SolidEkans/Flux-Capacitors/RESEARCH/Stock 350 SBC Timing Table.PNG

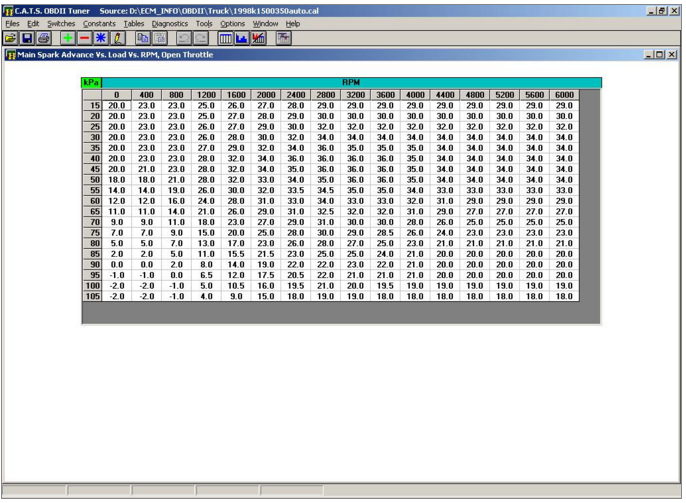
RESEARCH/Stock 350 SBC Timing Table.PNG
