SolidEkans/Flux-Capacitors/README.md

# Flux-Capacitors
Ryan Kachline
Calvin Nelson 
senior design timing box
