SolidEkans/Flux-Capacitors/SRC/Read Me.txt

The coding environment that you need is the Arduino coding enviroment.
A download for it is found at: https://www.arduino.cc/en/Main/Software
