SolidEkans/Flux-Capacitors/DESIGN_DOCUMENTATION/Flux Capacitors Schedule.xls

EE 403W Flux Capacitors, Ignition Timing Delay Box (ITDB) Spring 2016 Schedule
Week | Monday Lab 2:30PM- 4:25PM 301 EEW | Wednesday Lab 2:30PM- 4:25PM 301 EEW | Notes
2016-02-01 | Aquire Microcontroller, Probe Ignition on Car
2016-02-08 | Preliminary Design
2016-02-15 | Have Working Push button Delay
2016-02-22 | Design Power filter, Milestone Report
2016-02-29 | PCB Design
2016-03-07 | Spring Break | Spring Break | Spring Break
2016-03-14 | Assembly
2016-03-21 | Packaging Design
2016-03-28 | Stretch Goals
2016-04-04 | Stretch Goals, Milestone Report
2016-04-11 | Stretch Goals
2016-04-18 | Stretch Goals
2016-04-25 | Stretch Goals, Final Review
