SolidEkans/Flux-Capacitors/DESIGN_DOCUMENTATION/FluxCapacitors.PCBDesign/SCHEMATICS/FluxCapacitors.Schematic.pdf

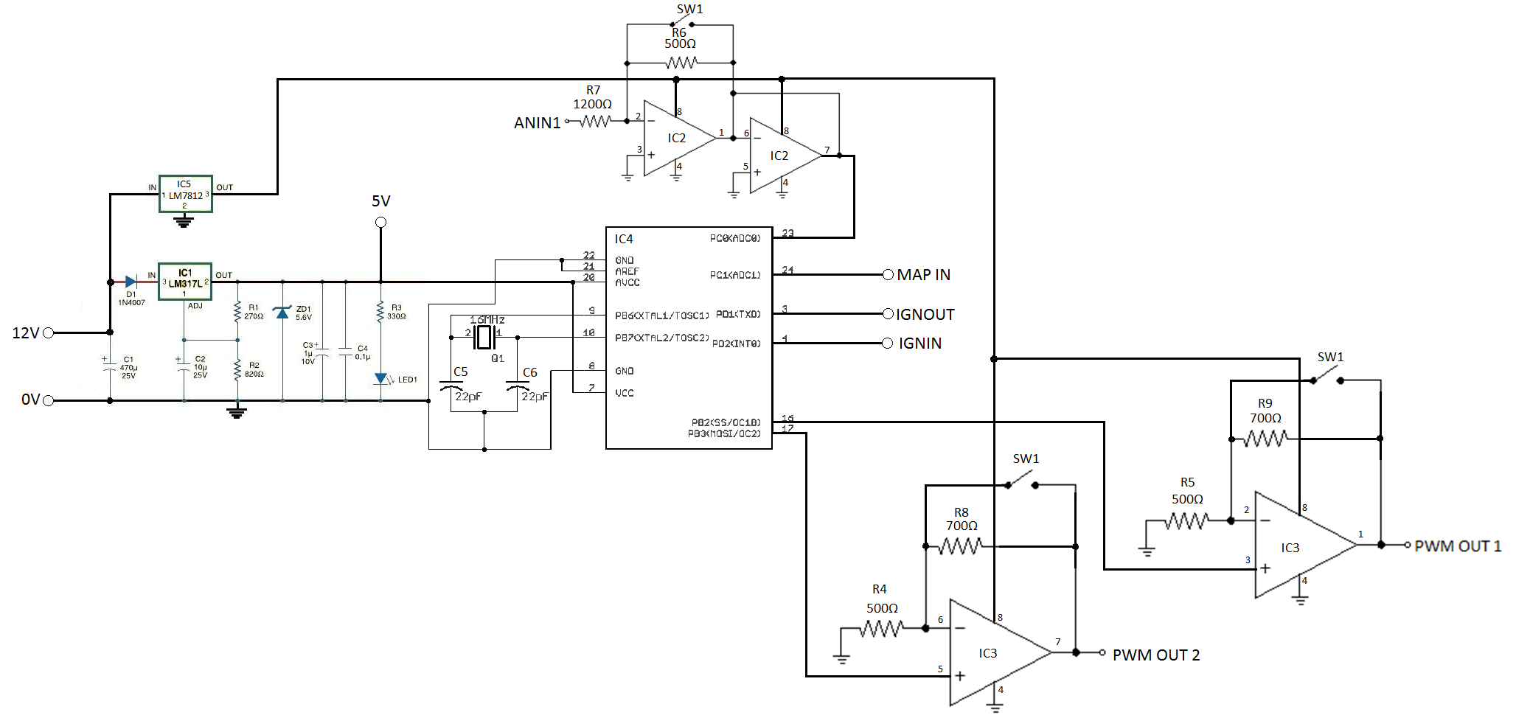
[picture p20: figure]
