SolidEkans/Flux-Capacitors/Grades/Design Review 1 Grades.xlsx

Flux Capacitors | External Reviewers |  |  |  | Students |  |  |  |  |  |  |  |  | Avg External Reviewer Score | AVG Student Score
Presentation Item | C | M | L | E |  |  |  |  |  |  |  |  |  |  |  | Weighted | Final Score
Did you understand the team's technical approach and how their proposed solution is supposed to work? | 9 | 10 | 9 | 10 | 9 | 7 | 9 | 10 | 7 | 7 | 7 | 7 | 10 | 9.5 | 7.875 | 8.6875 | 86.875
Rate the quality of the team's specifications. Were they stated clearly and did they describe quantifiable performance measures? | 9 | 8 | 8 | 10 | 9 | 9 | 9 | 10 | 8 | 9 | 9 | 7 | 9 | 8.75 | 8.75 | 8.75
Did team show any experimental data or technical progress? | 9 | 8 | 8 | 10 | 9 | 9 | 10 | 10 | 9 | 9 | 9 | 7 | 7 | 8.75 | 9 | 8.875
Did team know what their problem areas were? | 8 | 8 | 7 | 10 | 8 | 10 | 10 | 8 | 9 | 9 | 8 | 8 | 7 | 8.25 | 8.75 | 8.5
Rate overall progress on the project to-date | 8 | 8 | 8 | 10 | 8 | 10 | 10 | 10 | 9 | 10 | 8 | 9 | 6 | 8.5 | 9.25 | 8.875
Rate team's explanations of project challenges and risks | 7 | 9 | 8 | 10 | 7 | 9 | 9 | 9 | 9 | 8 | 8 | 8 | 10 | 8.5 | 8.375 | 8.4375
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
