SolidEkans/Flux-Capacitors/RESEARCH/Sine Phase Shifter Circuit.png

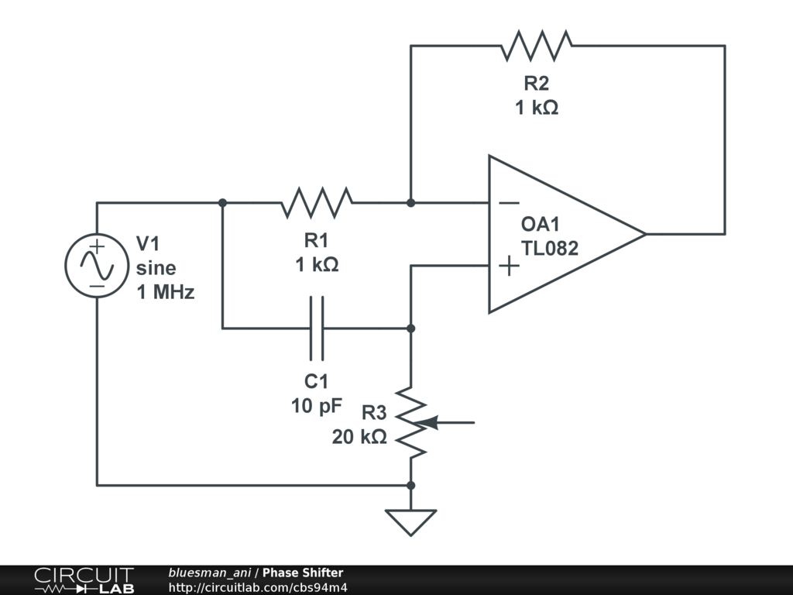
RESEARCH/Sine Phase Shifter Circuit.png
