SolidEkans/Flux-Capacitors/FluxCapacitors.PCBDesign/BOM/BOM.xlsx

Description | Quantity | Part Name On Schematic | Notes | Manufacturer | Manufacturer part Number | Source Part Number | Link | Unit Price | Ammount
atmega socket | 1 | socket |  | 3M | 4828-3004-CP | 3M5480-ND | http://www.digikey.com/product-detail/en/4828-3004-CP/3M5480-ND/1133633 | $0.73 | $0.73
16MHz crystal | 1 | Q1 |  | CTS-Frequency Controls | ATS16B | CTX1085-ND | http://www.digikey.com/product-detail/en/cts-frequency-controls/ATS16B/CTX1085-ND/2640031 | $0.36 | $0.36
22 pF cap | 2 | C5,C6 | "0805" polarized | Yageo | CC0805JRNPO9BN220 | 311-1103-1-ND | http://www.digikey.com/product-detail/en/yageo/CC0805JRNPO9BN220/311-1103-1-ND/303013 | $0.10 | $0.20
470 uF | 1 | C1 | polarized throughhole | Vishay BC Components | MAL202136471E3 | 4037PHCT-ND | http://www.digikey.com/product-detail/en/vishay-bc-components | $2.13 | $2.13
10 uF | 1 | C2 | "0805" | Murata Electronics North America | GCJ21BR71A106KE01L | 490-12646-1-ND | http://www.digikey.com/product-detail/en/GCJ21BR71A106KE01L/490-12646-1-ND/5797615 | $0.56 | $0.56
1 uF | 1 | C3 | "0805" | TDK Corporation | C2012X8R1C105K125AE | 445-173676-1-ND | http://www.digikey.com/product-detail/en/C2012X8R1C105K125AE/445-173676-1-ND/5809747 | $0.56 | $0.56
.1 uF | 1 | C4 | "0805" | Murata Electronics North America | GRM219R71E104KA01D | 490-12754-1-ND | http://www.digikey.com/product-detail/en/GRM219R71E104KA01D/490-12754-1-ND/5797723 | $0.12 | $0.12
LED | 1 | LED1 |  | Cree Inc. | C4SMF-GJS-CV0Y0792 | C4SMF-GJS-CV0Y0792CT-ND | http://www.digikey.com/product-detail/en/cree-inc/C4SMF-GJS-CV0Y0792/C4SMF-GJS-CV0Y0792CT-ND/1987473 | $0.29 | $0.29
5.6 v Zener | 1 | ZD1 |  | NXP Semiconductors | BZX79-C5V6 | 568-3846-1-ND | http://www.digikey.com/product-detail/en/BZX79-C5V6,133/568-3846-1-ND/1163127 | $0.13 | $0.13
1N4007 diode | 1 | D1 |  | Micro Commercial Co | 1N4007-TP | 1N4007-TPMSCT-ND | http://www.digikey.com/product-detail/en/micro-commercial-co/1N4007-TP/1N4007-TPMSCT-ND/773694 | $0.11 | $0.11
LM317L voltage regulator | 1 | IC1 |  | ON Semiconductor | LM317TG | LM317TGOS-ND | http://www.digikey.com/product-detail/en/LM317TG/LM317TGOS-ND/918508 | $0.53 | $0.53
wire sockets | 1 | wire harness | 10 sockets | TE Connectivity AMP Connectors | 1-1437664-4 | 1-1437664-4-ND | http://www.digikey.com/product-detail/en/te-connectivity-amp-connectors/1-1437664-4/1-1437664-4-ND/2258981 | $6.70 | $6.70
opamp | 2 | IC2 IC3 | ask eli | Fairchild Semiconductor | LF353N | LF353NFS-ND | http://www.digikey.com/product-detail/en/fairchild-semiconductor/LF353N/LF353NFS-ND/458668 | $0.51 | $1.02
270 ohm Resistor | 1 | R1 | "0603" | Yageo | RC0603JR-07270RL | 311-270GRCT-ND | http://www.digikey.com/product-detail/en/RC0603JR-07270RL/311-270GRCT-ND/729696 | $0.10 | $0.10
820 ohm resistor | 1 | R2 | "0603" | Yageo | RC0603JR-07820RL | 311-820GRCT-ND | http://www.digikey.com/product-detail/en/RC0603JR-07820RL/311-820GRCT-ND/729779 | $0.10 | $0.10
330 ohm resistor | 1 | R3 | "0603" | Yageo | RC0603JR-07330RL | 311-330GRCT-ND | http://www.digikey.com/product-detail/en/RC0603JR-07330RL/311-330GRCT-ND/729716 | $0.10 | $0.10
500 ohm resistor | 3 | R4 R5 R6 | "0603" | Yageo | RC0603FR-07499RL | 311-499HRCT-ND | http://www.digikey.com/product-detail/en/yageo/RC0603FR-07499RL/311-499HRCT-ND/730213 | $0.10 | $0.30
1200 ohm resistor | 1 | R7 | "0603" | Yageo | RC0603JR-071K2L | 311-1.2KGRCT-ND | http://www.digikey.com/product-detail/en/yageo/RC0603JR-071K2L/311-1.2KGRCT-ND/729630 | $0.10 | $0.10
700 ohm resistor | 2 | R8 R9 | "0603" | Stackpole Electronics Inc. | RMCF0603FT698R | RMCF0603FT698RCT-ND | http://www.digikey.com/product-detail/en/stackpole-electronics-inc/RMCF0603FT698R/RMCF0603FT698RCT-ND/1942992 | $0.10 | $0.20
aux voltage reg | 1 | IC5 |  | Fairchild Semiconductor | LM7812CT | LM7812CTFS-ND | http://www.digikey.com/product-detail/en/fairchild-semiconductor/LM7812CT/LM7812CTFS-ND/1923051 | $0.64 | $0.64
dip switch | 1 | SW1 | 3 switches | Omron Electronics Inc | A6S-3101-H | SW1386-ND | http://www.digikey.com/product-detail/en/omron-electronics-inc-emc-div/A6S-3101-H/SW1386-ND | $1.86 | $1.86
MCU | 1 | IC4 |  | Atmel | ATMEGA328-PU | ATMEGA328-PU-ND | http://www.digikey.com/product-detail/en/atmel/ATMEGA328-PU/ATMEGA328-PU-ND/2271026 | $3.38 | $3.38
 |  |  |  |  |  |  |  |  | $20.22
