SolidEkans/Flux-Capacitors/RESEARCH/parts list.xlsx

atmega socket | 1 | mcu |  | http://www.digikey.com/product-detail/en/4828-3004-CP/3M5480-ND/1133633
16MHz crystal | 1 | clk |  | stockroom? http://www.digikey.com/product-detail/en/ATS16B/CTX1085-ND/2640031
22 pF cap | 2 | C5,C6 | "0805" polarized | http://www.digikey.com/product-detail/en/CC0805JRNPO9BN220/311-1103-1-ND/303013
470 uF | 1 | C1 | polarized throughhole | stockroom
10 uF | 1 | C2 | 0805 polarized | http://www.digikey.com/product-detail/en/GCJ21BR71A106KE01L/490-12646-1-ND/5797615
1 uF | 1 | C3 | 0805 polarized | http://www.digikey.com/product-detail/en/C2012X8R1C105K125AE/445-173676-1-ND/5809747
.1 uF | 1 | C4 | 0805 unpolar | http://www.digikey.com/product-detail/en/GRM219R71E104KA01D/490-12754-1-ND/5797723
LED | 1 | LED |  | stockroom
5.6 v Zener | 1 | Zener |  | stockroom?? http://www.digikey.com/product-detail/en/BZX79-C5V6,133/568-3846-1-ND/1163127
1N4007 diode | 1 | Diode |  | stockroom
LM317L voltage regulator | 1 | Vreg |  | http://www.digikey.com/product-detail/en/LM317TG/LM317TGOS-ND/918508 (stockroom??)
wire sockets | 10 sockets |  |  | http://www.digikey.com/product-detail/en/te-connectivity-amp-connectors/1-1437664-4/1-1437664-4-ND/2258981
opamp 4 op amps(2 dips) | 2 |  | ask eli | http://www.digikey.com/product-detail/en/fairchild-semiconductor/LF353N/LF353NFS-ND/458668
270 ohm Resistor | 1 | R1 | "0603" | http://www.digikey.com/product-detail/en/RC0603JR-07270RL/311-270GRCT-ND/729696
820 ohm resistor | 1 | R2 | "0603" | http://www.digikey.com/product-detail/en/RC0603JR-07820RL/311-820GRCT-ND/729779
330 ohm resistor | 1 | R3 | "0603" | http://www.digikey.com/product-detail/en/RC0603JR-07330RL/311-330GRCT-ND/729716
500 ohm resistor | 3 | R2 MAP / (R1DIO11/12) | "0603" | http://www.digikey.com/product-detail/en/yageo/RC0603FR-07499RL/311-499HRCT-ND/730213
1200 ohm resistor | 1 | R1MAP | "0603" | http://www.digikey.com/product-detail/en/yageo/RC0603JR-071K2L/311-1.2KGRCT-ND/729630
700 ohm resistor | 2 | R2DIO11/12 | "0603" | http://www.digikey.com/product-detail/en/stackpole-electronics-inc/RMCF0603FT698R/RMCF0603FT698RCT-ND/1942992
aux voltage reg |  |  |  | http://www.digikey.com/product-detail/en/fairchild-semiconductor/LM7812CT/LM7812CTFS-ND/1923051
