SolidEkans/Flux-Capacitors/WORKING FILES/Accuracy Testing.xlsx

Delay (degrees) | Measured Delay (ms) | Theoretical Delay (ms) | Measured Dwell (ms) | Straddling Negative edge?
f=12Hz, T=0.083333, 180RPM
3 | 2.86 | 2.777776667 | 3.1 | y | 0.9712505828 | -0.08222333333
4 | 3.84 | 3.703702222 | 3.64 | n | 0.964505787 | -0.1362977778
5 | 4.76 | 4.629627778 | 3.64 | n | 0.9726108777 | -0.1303722222
6 | 5.68 | 5.555553333 | 3.64 | n | 0.9780903756 | -0.1244466667
7 | 6.64 | 6.481478889 | 3.64 | n | 0.9761263387 | -0.1585211111
8 | 7.54 | 7.407404444 | 3.64 | n | 0.9824143826 | -0.1325955556
9 | 8.48 | 8.33333 | 3.64 | n | 0.9827040094 | -0.14667
10 | 9.44 | 9.259255556 | 3.64 | n | 0.9808533427 | -0.1807444444
15 | 14.06 | 13.88888333 | 3.64 | n | 0.9878295401 | -0.1711166667
20 | 18.7 | 18.51851111 | 3.64 | n | 0.9902947118 | -0.1814888889
25 | 23.4 | 23.14813889 | 3.64 | n | 0.9892367047 | -0.2518611111
30 | 28.05 | 27.77776667 | 3.64 | n | 0.9902947118 | -0.2722333333
35 | 32.7 | 32.40739444 | 3.64 | n | 0.9910518179 | -0.2926055556
40 | 37.4 | 37.03702222 | 3.64 | n | 0.9902947118 | -0.3629777778
45 | 42 | 41.66665 | 3.64 | n | 0.9920630952 | -0.33335
50 | 46.7 | 46.29627778 | 3.64 | n | 0.9913549845 | -0.4037222222
f=50Hz, T=0.02, 750RPM
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
