SolidEkans/Flux-Capacitors/TESTING/Mag pickup 2.png

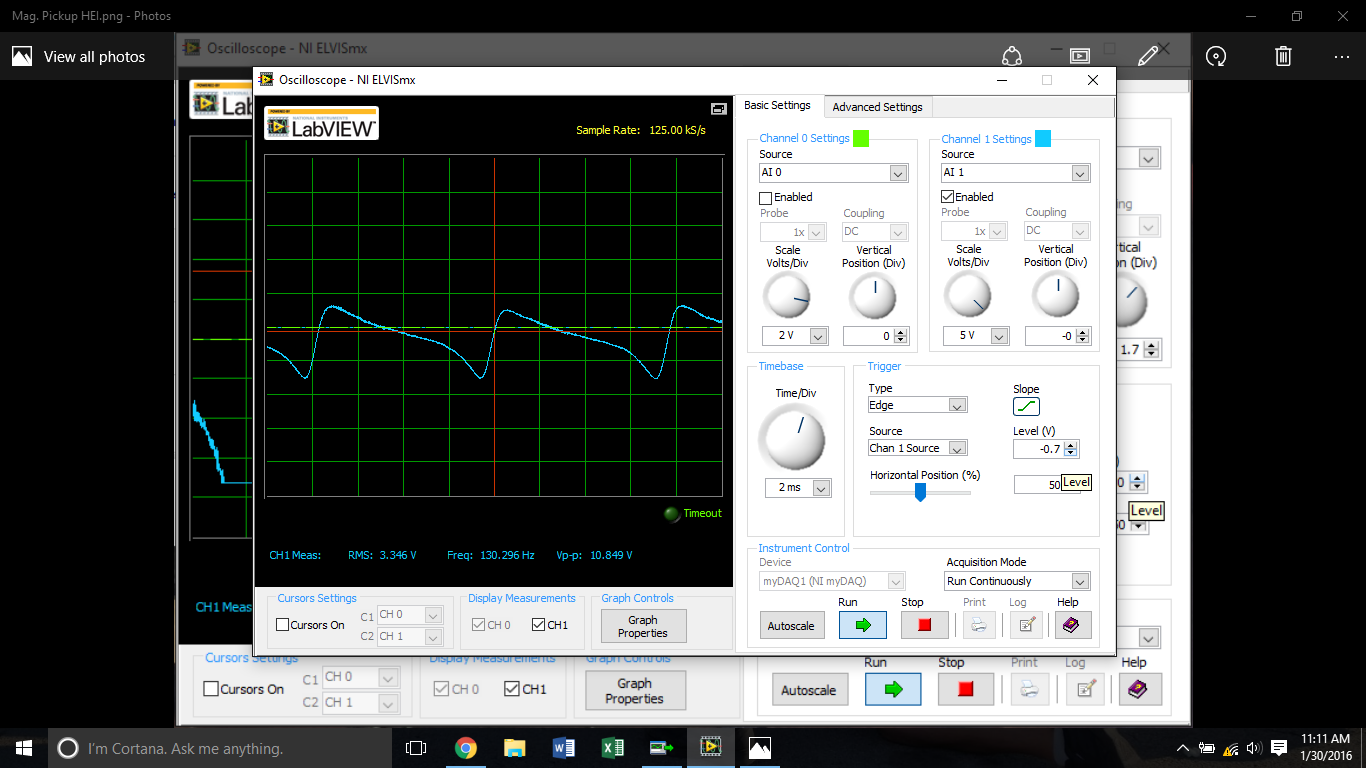
TESTING/Mag pickup 2.png
