SolidEkans/Flux-Capacitors/TESTING/mag pickup 3.png

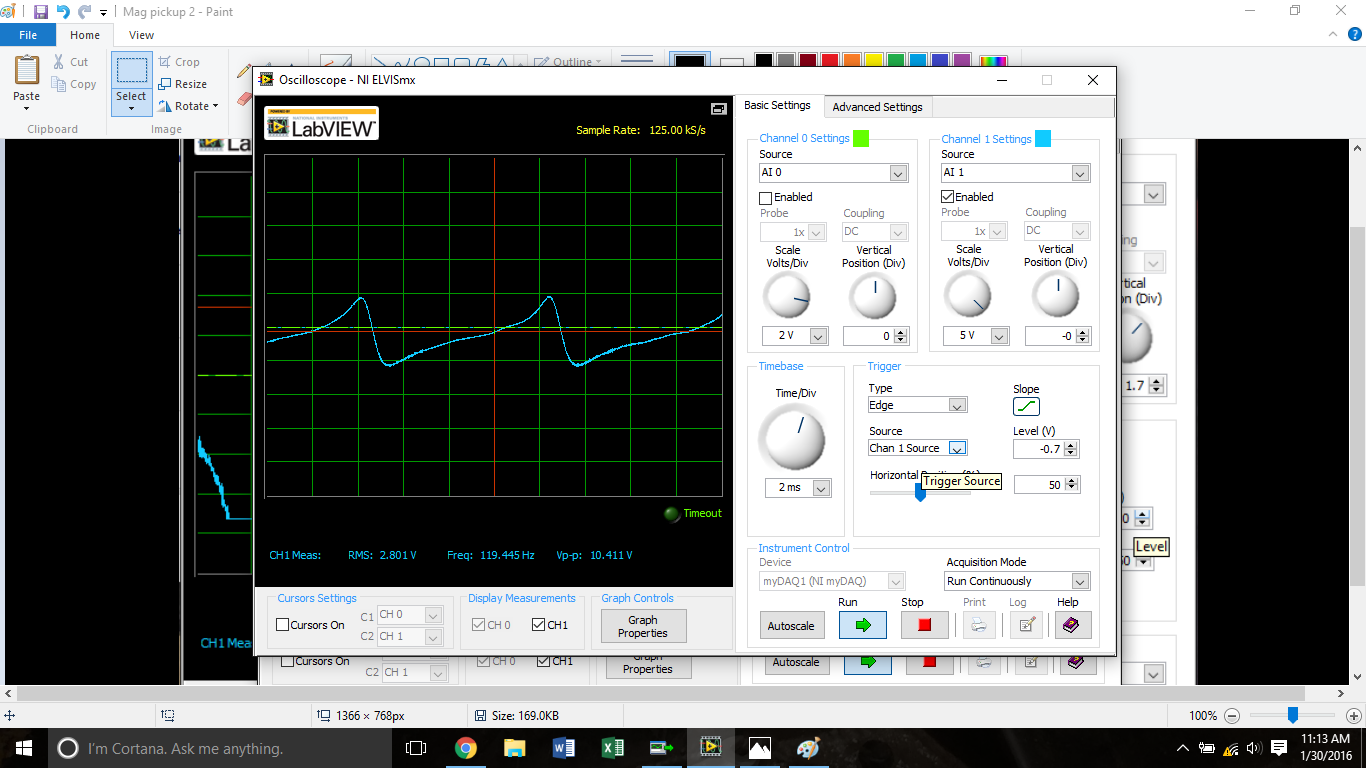
TESTING/mag pickup 3.png
