SolidEkans/Flux-Capacitors/TESTING/Mag. Pickup HEI.png

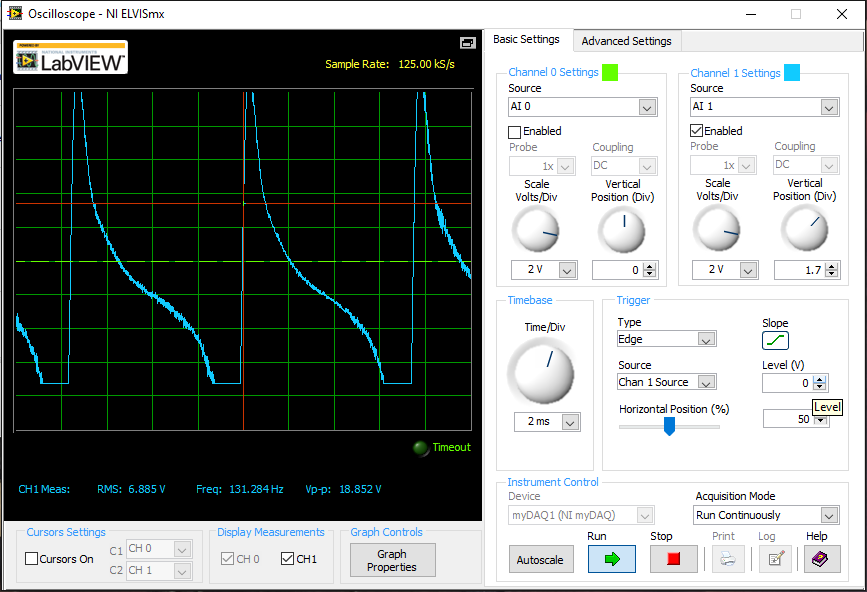
TESTING/Mag. Pickup HEI.png
