SolidEkans/Flux-Capacitors/TESTING/R signal.png

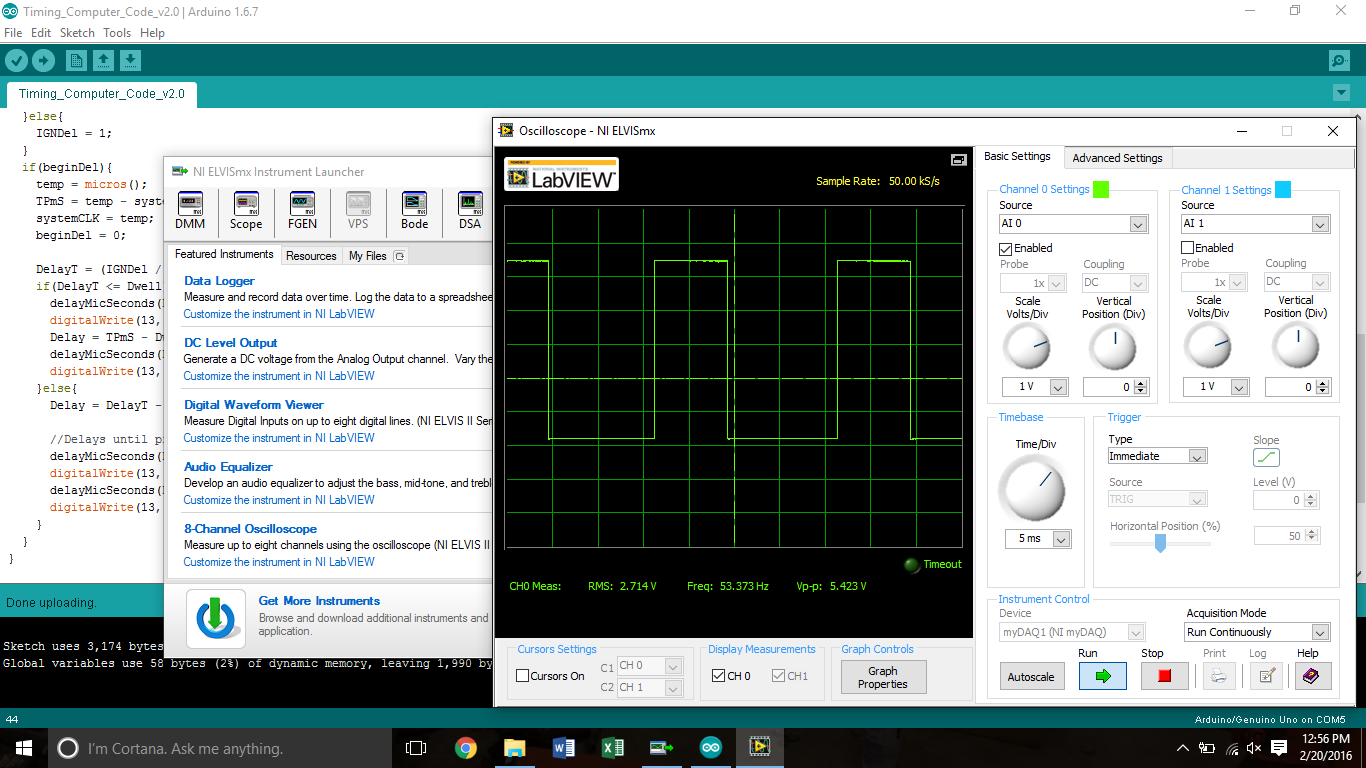
TESTING/R signal.png
