SolidEkans/Flux-Capacitors/TESTING/test 1 not working right, dwell 3600, first chunk 44 deg ign timing.png

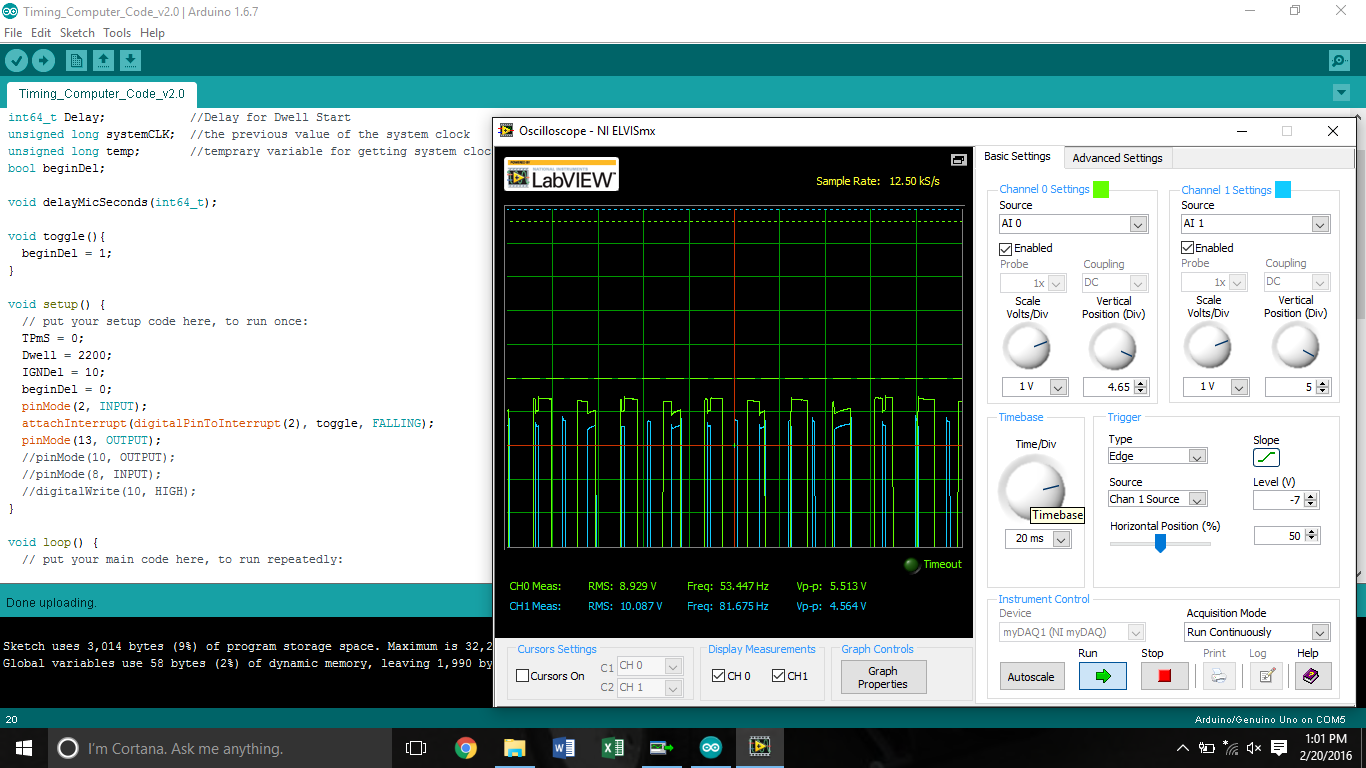
TESTING/test 1 not working right, dwell 3600, first chunk 44 deg ign timing.png
