SolidEkans/Flux-Capacitors/TESTING/test 2 not working right second chunk of code.png

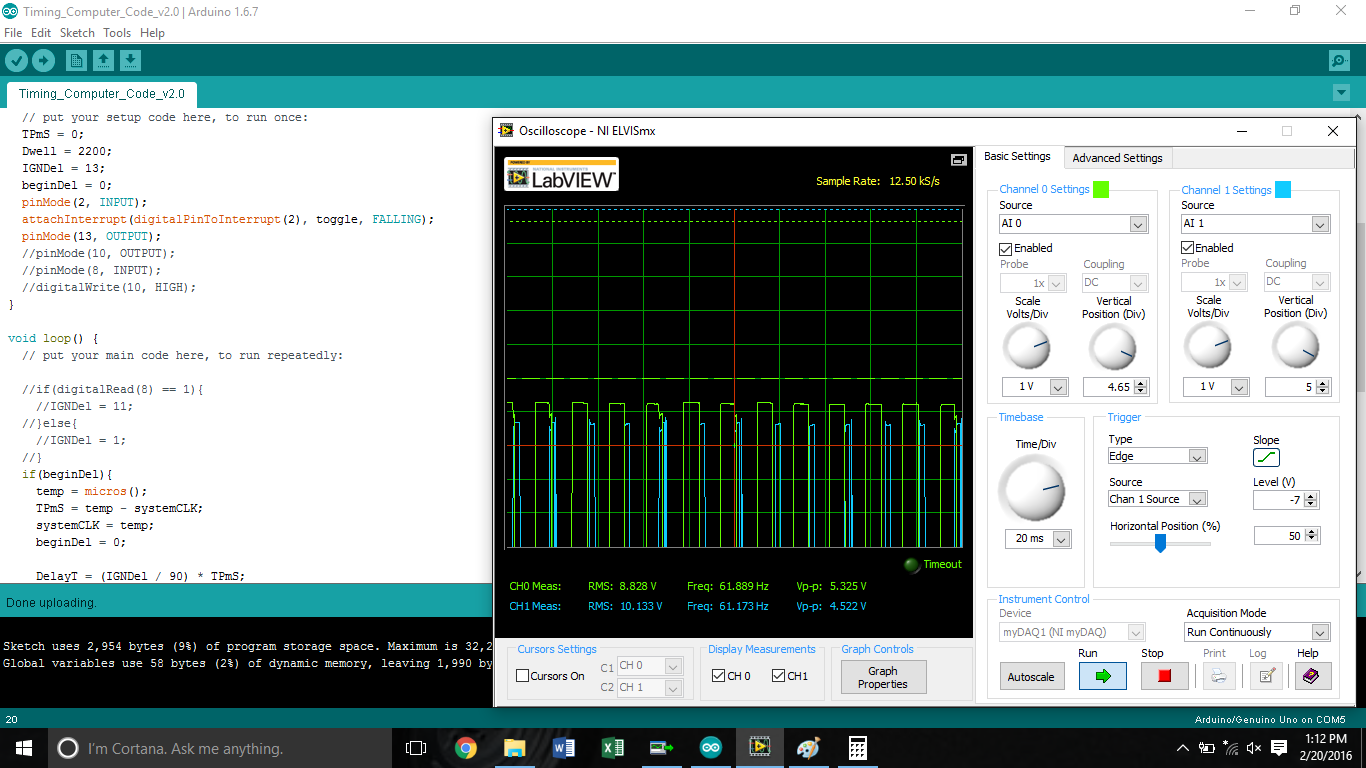
TESTING/test 2 not working right second chunk of code.png
