SolidEkans/Flux-Capacitors/TESTING/test 4 not working right, second chunk, dwell 2000.png

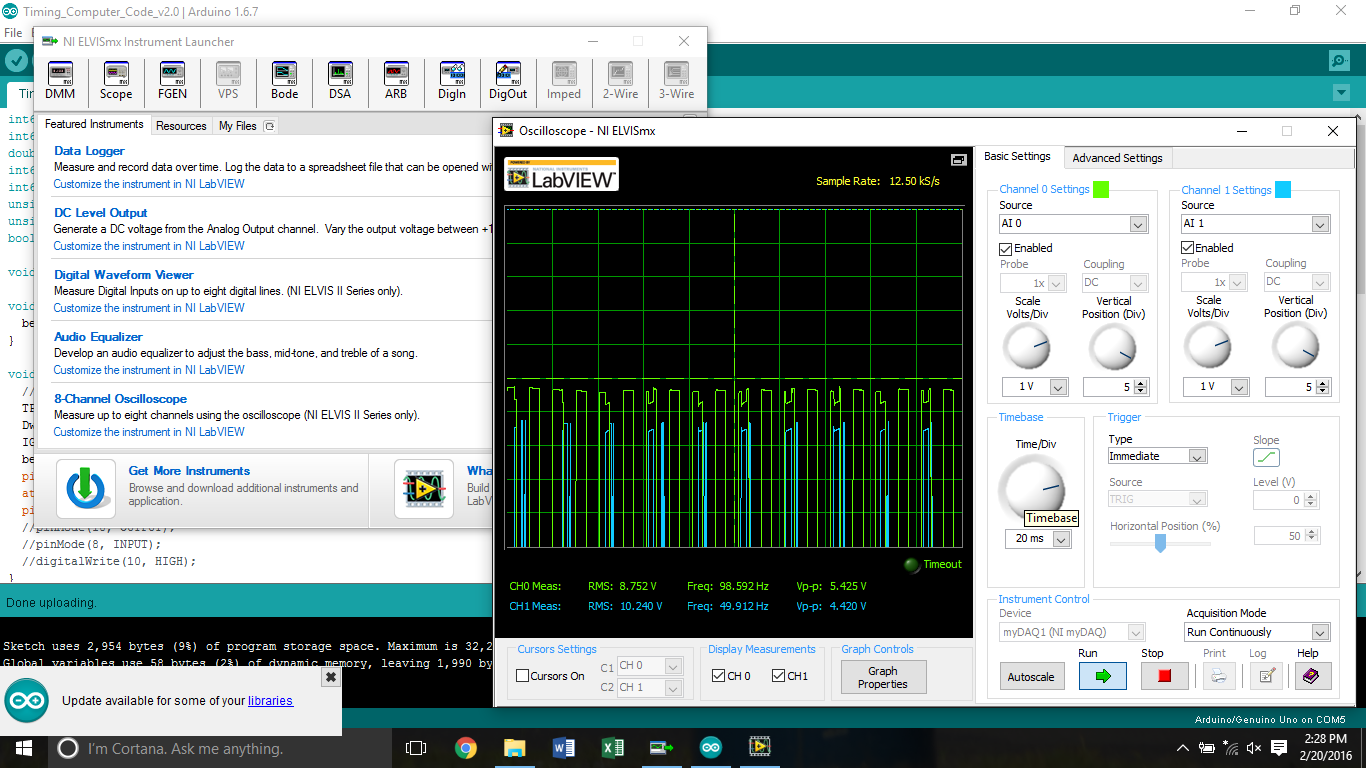
TESTING/test 4 not working right, second chunk, dwell 2000.png
