SolidEkans/Flux-Capacitors/(list of files, drawings)

Other design files:
RESEARCH/LM317 Regulator.ms13
