SolidEkans/Flux-Capacitors/(commit log)

2016-01-25 Added blank powerpoint for Design Plan
2016-01-25 Added Added documents for design proposal
    [Flux Capacitors Schedule.xls, FluxCapacitors.Budget.xlsx]
2016-01-27 Finished Design Plan
    [FluxCapacitors.Budget.xlsx]
2016-02-03 added usb power supply msim
    [usb power supply.ms13]
2016-02-03 added prelim designs
    [power supply.ms13, usb power supply.ms13]
2016-02-03 Code for Arduino Started
2016-02-08 updated pcb design
    [LM317 Regulator.ms13, power supply.ms13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]
2016-02-10 update to pcb design
    [LM317 Regulator.ms13]
2016-02-15 added link to screw connectors
2016-02-17 Fixed delay problem in code
    [Accuracy Testing.xlsx]
2016-02-22 bill of materials updated
    [parts list.xlsx]
2016-02-29 added oscope capture
    [LM317 Regulator.ms13, parts list.xlsx]
2016-02-29 CDR done except for PCB
2016-03-01 pcb damn near done
    [LM317 Regulator.ms13, parts list.xlsx]
2016-03-02 Updated CDR with Schematics for PCB
2016-03-02 gerber files added
    [parts list.xlsx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]
2016-03-03 Gerber files sent
    [IGN_TIMING_COMP- Board Outline.gbr, IGN_TIMING_COMP- Copper Bottom.GBL, IGN_TIMING_COMP- Copper Top-Copper Bottom.drl, IGN_TIMING_COMP- Copper Top.GTL, IGN_TIMING_COMP- Silkscreen Bottom.GBO, IGN_TIMING_COMP- Silkscreen Top.GTO, IGN_TIMING_COMP- Solder Mask Bottom.GBS, IGN_TIMING_COMP- Solder Mask Top.GTS]
2016-03-04 updated parts list
    [parts list.xlsx]
2016-03-14 Created video demonstrating the functionality of the device
2016-03-16 Design Review Grades
    [Design Review 1 Grades.xlsx]
2016-03-16 created pcb design folder
    [BOM.xlsx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]
2016-03-28 tweaks to pcb
2016-03-30 revisions to pcb
    fixed op amps and rogue traces
2016-04-04 Almost done implementing MAP referencing
    [Design Review 1 Grades.xlsx]
2016-04-11 added invoices to pcb folder
2016-04-11 made schematic
2016-04-11 fixed schematic
2016-04-11 made folder for submittable files for PCB
2016-04-11 fixed naming convention of pcb submittables
2016-04-11 finalized pcb documents
    [BOM.xlsx]
2016-04-11 pcb folder
    [BOM.xlsx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]
2016-04-11 PCB submittables complete
2016-04-13 PCB Submittables done
2016-04-13 Revert "PCB Submittables done"
    This reverts commit 0eeff1b0d4993bda47d574229d18f6618a3b1266.
2016-04-13 bom update
    [BOM.xlsx]
